MNSGC-Ballooning/MURI-HASP_2019/HASP_PCB/HASP_ThruHole/Schematic_rev1.brd

## EAGLE design SHADOMS_Flight_Computer/HASP_PCB/HASP_ThruHole/Schematic_rev1.brd (2019-06-05, last stored version)

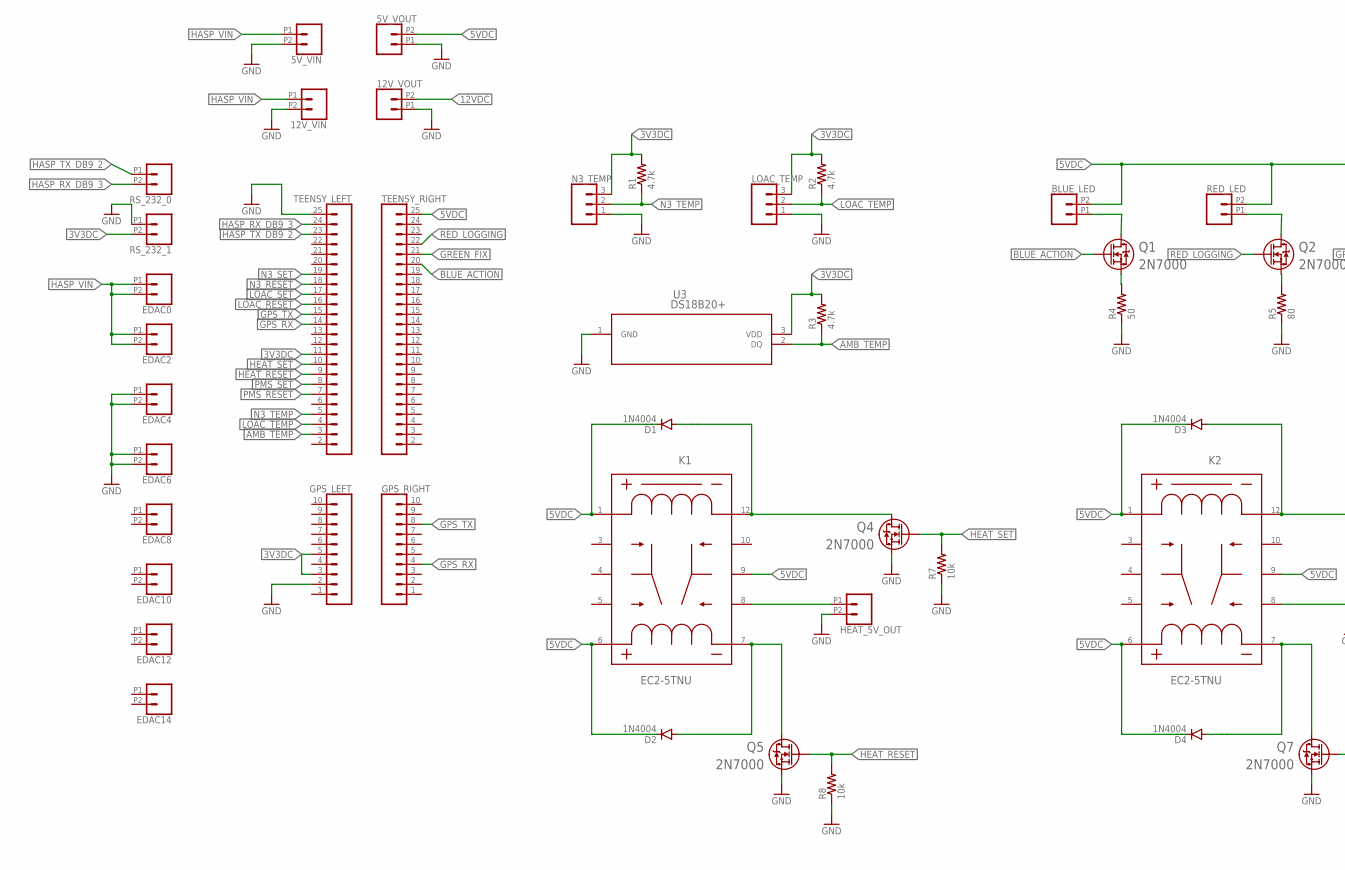
[picture p32: schematic Schematic_rev1.sch, part in row 1, column 1]

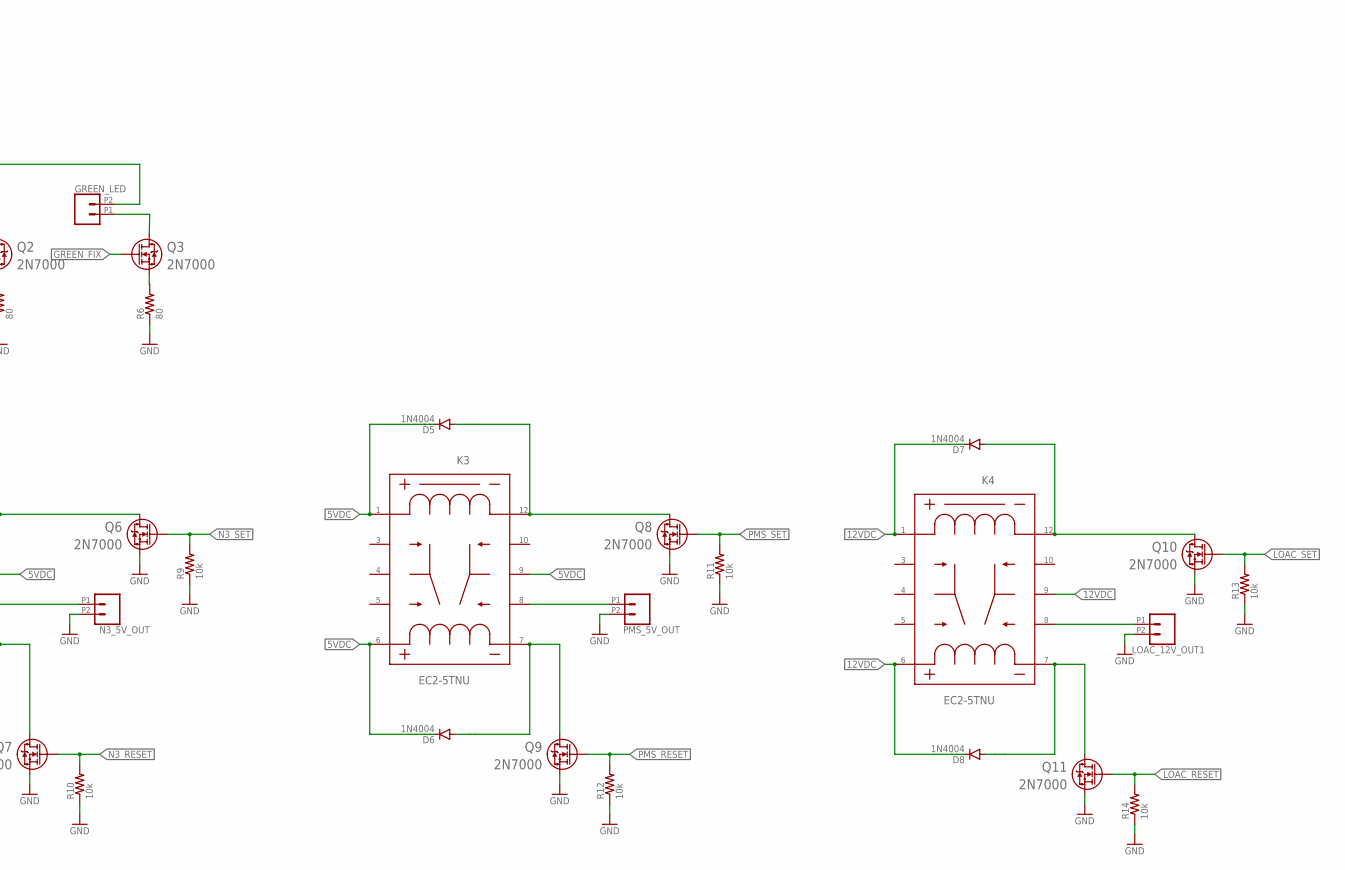
[picture p33: schematic Schematic_rev1.sch, part in row 1, column 2]

Parts:
5V_VIN, 5V_VOUT, 12V_VIN, 12V_VOUT: CONN_022.54MM_SCREWTERM; 1X02_2.54_SCREWTERM
BLUE_LED: CONN_022.54MM_SCREWTERM; 1X02_2.54_SCREWTERM
D1, D2, D3, D4, D5, D6, D7, D8: 1N4004; DO41-10
EDAC0, EDAC2, EDAC4, EDAC6, EDAC8, EDAC10, EDAC12, EDAC14: CONN_022.54MM_SCREWTERM; 1X02_2.54_SCREWTERM
GPS_LEFT: CONN_10"; 1X10
GPS_RIGHT: CONN_10"; 1X10
GREEN_LED: CONN_022.54MM_SCREWTERM; 1X02_2.54_SCREWTERM
HEAT_5V_OUT: CONN_022.54MM_SCREWTERM; 1X02_2.54_SCREWTERM
K1, K2, K3, K4: EC2-5TNU; EC2TNU
LOAC_12V_OUT1: CONN_022.54MM_SCREWTERM; 1X02_2.54_SCREWTERM
LOAC_TEMP: CONN_03; 1X03
N3_5V_OUT: CONN_022.54MM_SCREWTERM; 1X02_2.54_SCREWTERM
N3_TEMP: CONN_03; 1X03
PMS_5V_OUT: CONN_022.54MM_SCREWTERM; 1X02_2.54_SCREWTERM
Q1, Q2, Q3, Q4, Q5, Q6, Q7, Q8, Q9, Q10, Q11: 2N7000; TO-92
R1, R2, R3: 4.7k; 0207/7
R4: 50; 0207/7
R5, R6: 80; 0207/7
R7, R8, R9, R10, R11, R12, R13, R14: 10k; 0207/7
RED_LED: CONN_022.54MM_SCREWTERM; 1X02_2.54_SCREWTERM
RS_232_0, RS_232_1: CONN_022.54MM_SCREWTERM; 1X02_2.54_SCREWTERM
TEENSY_LEFT: CONN_24; 1X24
TEENSY_RIGHT: CONN_24; 1X24
U3: DS18B20+; 21-0248A

Connections:
3V3DC: GPS_LEFT.3, GPS_LEFT.5, LOAC_TEMP.3, N3_TEMP.3, R1.2, R2.2, R3.2, RS_232_1.P2 (2), TEENSY_LEFT.11, U3.3 (VDD)
5VDC: 5V_VOUT.P2 (2), BLUE_LED.P2 (2), D1.C, D2.C, D3.C, D4.C, D5.C, D6.C, GREEN_LED.P2 (2), K1.1, K1.6 (5), K1.9 (8), K2.1, K2.6 (5), K2.9 (8), K3.1, K3.6 (5), K3.9 (8), RED_LED.P2 (2), TEENSY_RIGHT.25
12VDC: 12V_VOUT.P2 (2), D7.C, D8.C, K4.1, K4.6 (5), K4.9 (8)
AMB_TEMP: R3.1, TEENSY_LEFT.3, U3.2 (DQ)
BLUE_ACTION: Q1.2 (1), TEENSY_RIGHT.20
GND: 5V_VIN.P2 (2), 5V_VOUT.P1 (1), 12V_VIN.P2 (2), 12V_VOUT.P1 (1), EDAC4.P1 (1), EDAC4.P2 (2), EDAC6.P1 (1), EDAC6.P2 (2), GPS_LEFT.2, HEAT_5V_OUT.P2 (2), LOAC_12V_OUT1.P2 (2), LOAC_TEMP.1, N3_5V_OUT.P2 (2), N3_TEMP.1, PMS_5V_OUT.P2 (2), Q4.1 (3), Q5.1 (3), Q6.1 (3), Q7.1 (3), Q8.1 (3), Q9.1 (3), Q10.1 (3), Q11.1 (3), R4.1, R5.1, R6.1, R7.1, R8.1, R9.1, R10.1, R11.1, R12.1, R13.1, R14.1, RS_232_1.P1 (1), TEENSY_LEFT.25, U3.1 (GND)
GPS_RX: GPS_RIGHT.4, TEENSY_LEFT.14
GPS_TX: GPS_RIGHT.8, TEENSY_LEFT.15
GREEN_FIX: Q3.2 (1), TEENSY_RIGHT.21
HASP_RX_DB9_3: RS_232_0.P2 (2), TEENSY_LEFT.24
HASP_TX_DB9_2: RS_232_0.P1 (1), TEENSY_LEFT.23
HASP_VIN: 5V_VIN.P1 (1), 12V_VIN.P1 (1), EDAC0.P1 (1), EDAC0.P2 (2), EDAC2.P1 (1), EDAC2.P2 (2)
HEAT_RESET: Q5.2 (1), R8.2, TEENSY_LEFT.9
HEAT_SET: Q4.2 (1), R7.2, TEENSY_LEFT.10
LOAC_RESET: Q11.2 (1), R14.2, TEENSY_LEFT.16
LOAC_SET: Q10.2 (1), R13.2, TEENSY_LEFT.17
LOAC_TEMP: LOAC_TEMP.2, R2.1, TEENSY_LEFT.4
N3_RESET: Q7.2 (1), R10.2, TEENSY_LEFT.18
N3_SET: Q6.2 (1), R9.2, TEENSY_LEFT.19
N3_TEMP: N3_TEMP.2, R1.1, TEENSY_LEFT.5
unnamed: BLUE_LED.P1 (1), Q1.3 (2)
unnamed: Q1.1 (3), R4.2
unnamed: D2.A, K1.7 (6), Q5.3 (2)
unnamed: Q2.3 (2), RED_LED.P1 (1)
unnamed: Q2.1 (3), R5.2
unnamed: Q3.1 (3), R6.2
unnamed: GREEN_LED.P1 (1), Q3.3 (2)
unnamed: D4.A, K2.7 (6), Q7.3 (2)
unnamed: D3.A, K2.12 (10), Q6.3 (2)
unnamed: D1.A, K1.12 (10), Q4.3 (2)
unnamed: K2.8 (7), N3_5V_OUT.P1 (1)
unnamed: D6.A, K3.7 (6), Q9.3 (2)
unnamed: HEAT_5V_OUT.P1 (1), K1.8 (7)
unnamed: D5.A, K3.12 (10), Q8.3 (2)
unnamed: K3.8 (7), PMS_5V_OUT.P1 (1)
unnamed: D8.A, K4.7 (6), Q11.3 (2)
unnamed: D7.A, K4.12 (10), Q10.3 (2)
unnamed: K4.8 (7), LOAC_12V_OUT1.P1 (1)
PMS_RESET: Q9.2 (1), R12.2, TEENSY_LEFT.7
PMS_SET: Q8.2 (1), R11.2, TEENSY_LEFT.8
RED_LOGGING: Q2.2 (1), TEENSY_RIGHT.22

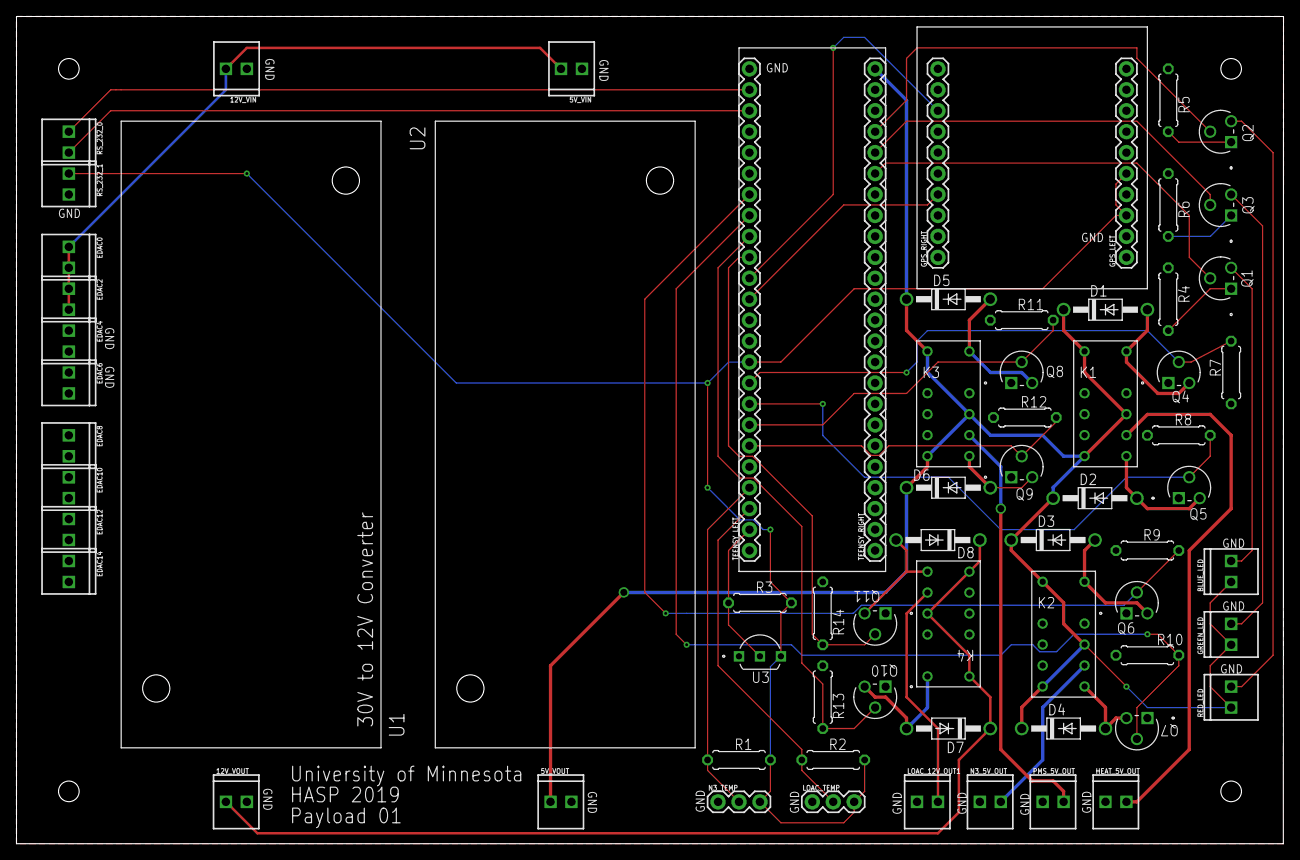
[picture p34: board Schematic_rev1.brd from above]

Board: 2 copper layers, 153.7 x 100.3 mm, 65 parts (0 on the bottom side), 41 nets.
