MNSGC-Ballooning/MURI-HASP_2019/SHADOMS_Flight_Computer/SHADOMS_Flight_Computer.ino

//SHADOMS Payload Flight Computer
//Version 1.0.1
//Payload 2019-01

/*This code operates the Teensy 3.5/3.6 Microcontroller on the 2019 HASP flight.
The goal of this flight is to collect data from the Plantower PMS-5003, the Alphasense N3,
and the LOAC-R. Then, this data will be compared to examine how each particle detector operates
in the conditions of the upper atmosphere. This examination will be utilized to determine OPC
effectiveness and calibration needs for future MURI research.

The code operates the particle counter power, writes the data of the Plantower to disk,
regulates temperature using active heating, runs a Coperinicus GPS, and controls uplink
and downlink with the main HASP gondola.

In this setup, both the Alphasense and the LOAC are running in a standalone mode where they 
record their own data.*/

//University of Minnesota- Twin Cities
//Candler-MURI Research Team
//Written in June 2019

//Version History
//Version 1.0.1
/*This version of the code has extra notes, in addition to comments, about things that might have been changed or done in a
different way if HASP was attempted again. Other documentation will be put up with the code in a folder for future reference.*/

//Version 1.0
/*This version of the code is modified to work with HASP serial connection. This code officially passed the HASP thermal
vaccuum, power, and operations tests. This is the code that will fly on the actual HASP flight.*/

//Version 0.4
/*This version seeks to counter the overheating problem by adding robust thermal control. The goal is to add active cooling,
and to turn off systems when they reach an unsafe operating temperature. This update also fixed the LOAC logging, which derives
its error from the transistor switch implemented for system shutdown. The flight timer was updated to successfully log the 
difference between flight start and poweron, and the SD Log was changed to add fillers when the data is not available.
The serial string now has the ability to send plantower data. Additionally, various bug fixes and code cleanup occurred.*/

//Version 0.3
/*Passed all individual unit tests and full system test. Updated update and log rates, updated GPS system. 
Returned system to hardware serial. Updated LED to show satellite count, and logging time. Added more debugging 
and code cleanup. Passed all initialization into functions separated by system. Added serial initialization pauses.*/

//Version 0.2
/*Passed initial unit tests for thermal control, GPS. This version also updates
the plantower logging system (returning to software serial), updates the LED pins, and fixes various bugs
and unclean code. The system log and the plantower log have also been collapsed.*/

//Version 0.1
/*Updated the serial port system to impliment hardware serial connections in place of software serial.
This will allow for the system to interface with multiple serial systems simaltaneously. This version also
implemented the serial interface with the HASP gondala and established meanings for the LEDs.*/

//Version 0.0
/*This is the initial code after the first stage of debugging.*/



/////SYSTEM DEFINITIONS\\\\\



//Libraries
  #include <SD.h>                                       //Writing to SD card
  #include <OneWire.h>                                  //Dallas data control
  #include <DallasTemperature.h>                        //Dallas temperature control
  #include <TinyGPS++.h>                                //GPS control
  #include <LatchRelay.h>                               //Relay control

//Pin Definitions
  #define sdLED 23                                      //LED pin which blinks to indicates data logging to the SD            NOTE: An OLED screen can be used to replace LEDs
  #define fixLED 22                                     //LED pin which blinks to indicate GPS fix
  #define stateLED 21                                   //LED pin which blinks to indicate an active data recording status
  #define wireBus1 29                                   //Temperature sensor 1 pin - Internal Ambient
  #define wireBus2 30                                   //Temperature sensor 2 pin - External Ambient
  #define wireBus3 31                                   //Temperature sensor 3 pin - OPCs
  #define heater_ON 24                                  //Heater relay pins
  #define heater_OFF 25                                 //^^^
  #define alphaOPC_ON 5                                 //Alphasense OPC relay pins
  #define alphaOPC_OFF 6                                //^^^
  #define planOPC_ON 26                                 //Plantower OPC relay pins
  #define planOPC_OFF 27                                //^^^
  #define LOAC_ON 7                                     //LOAC OPC power relay pins
  #define LOAC_OFF 8                                    //^^^
  #define LS_PD 35                                      //LOAC state shutdown transistor
  #define LOAC_FAN 32                                   //LOAC fan pin
  
//Serial Pins
/*  
  #define HASP_RX 0                                     //HASP Recieve Pin                SERIAL 1
  #define HASP_TX 1                                     //HASP Transmission Pin
  #define GPS_RX 9                                      //GPS Recieve Pin                 SERIAL 2
  #define GPS_TX 10                                     //GPS Transmission Pin
  #define PMS_RX 34                                     //PMS Recieve Pin                 SERIAL 5
  #define PMS_TX 33                                     //PMS Transmission Pin (Unused) 
*/
 
//Constant Definitions
  #define LOG_RATE 7000                                 //These definitions are the rates of the individual portions of the
  #define UPDATE_RATE 1                                 //systemUpdate function.
  #define FIXLED_LOOP 15000                             //FixLED cycles every 15 seconds
  #define FIXLED_RATE 500                               //FixLED is held on for 0.5 seconds
  #define NOFIXLED_RATE 3000                            //When there is no GPS fix, FixLED cycles is held on for 3 seconds
  #define DWN_BYTES 57                                  //Number of downlink bytes + 1 (the +1 makes it work)
  #define COLD 280.0                                    //Minimum acceptable temperature of the OPC
  #define HOT 290.0                                     //Maximum acceptable temperature of the OPC
  #define KELVIN 273.15                                 //Number to convert Celcius to Kelvin
  #define INFLIGHT_START_ALT 10000                      //Altitude in feet where the inFlight condition is set to true
  #define MIN_FANTEMP 300.0                             //Minimum acceptable temperature of the OPC for active cooling
  #define MAX_TEMP 313.1                                //Maximum operating temperature of the OPC
  #define MIN_TEMP 243.2                                //Minimum operating temperature of the OPC
  #define OVERRIDE_TIME 1500000                         //Time of the override command
  
//Relay Definitions
  LatchRelay heater(heater_ON, heater_OFF);             //Define heater relay object
  LatchRelay alphaOPC(alphaOPC_ON, alphaOPC_OFF);       //Define Alphasense OPC relay object
  LatchRelay planOPC(planOPC_ON, planOPC_OFF);          //Define Plantower OPC relay object
  LatchRelay LOAC(LOAC_ON, LOAC_OFF);                   //Define LOAC OPC power relay object
  bool dataCollection = false;
  
//Thermal Control Definitions
  bool coldOPC = false;
  bool hotOPC = false;
  bool danger = false;                                  //danger runs an emergency shutdown of the OPC system
  bool overRide = false;                                //manual system override mechanism
  unsigned long overrideTimer = 0;
  char fanState = '0';                                  //Defines the stae of the LOAC fan. "0" means off, "1" means on
  bool initialCheck = false;

//Temperature Sensor Definitions
  OneWire oneWire1(wireBus1);                           //Temperature sensor 1 data interface
  OneWire oneWire2(wireBus2);                           //Temperature sensor 2 data interface
  OneWire oneWire3(wireBus3);                           //Temperature sensor 3 data interface
  DallasTemperature temperature1(&oneWire1);            //Temperature sensor 1
  DallasTemperature temperature2(&oneWire2);            //Temperature sensor 2
  DallasTemperature temperature3(&oneWire3);            //Temperature sensor 3
  float t1;                                             //Temperature 1
  float t2;                                             //Temperature 2
  float t3;                                             //Temperature 3
  char heatState = '0';                                 //heat pad status (1 = on)
  
//Serial Definitions (HASP Communication)
  String flightState = "";
  String OPCState = "";
  String dataPacket = "";
  byte packet[DWN_BYTES] = {0};                         //50 char/bytes in the string (54 with checkbytes)                    NOTE: The checkbytes act as start and stop bytes. 
  
//Data Log Definitions
  const int chipSelect = BUILTIN_SDCARD;                //Access on board micro-SD
  File fLog;                                            //This part of the code establishes the file and
  String data;                                          //sets up the CSV format
  String Fname = "";                                    //This is the name of the CSV file
  String header = "";                                   //This is the head of the CSV file
  bool sdLogging = false;                               //This variable is used to indicate when logging occurs
  
//Plantower Definitions
  String dataLog = "";                                  //Used for data logging                                               NOTE: A library now exists for OPCs.
  int nhits=1;                                          //Used to count successful data transmissions    
  int ntot=1;                                           //Used to count total attempted transmissions
  bool goodLog = false;                                 //Used to check if data is actually being logged
  int badLog = 0;                                       //Counts the number of failed log attempts
  //String filename = "ptLog.csv";                      //File name that data wil be written to
  //File ptLog;                                         //File that data is written to 
                  
  struct pms5003data {
    uint16_t framelen;
    uint16_t pm10_standard, pm25_standard, pm100_standard;
    uint16_t pm10_env, pm25_env, pm100_env;
    uint16_t particles_03um, particles_05um, particles_10um;
    uint16_t particles_25um, particles_50um, particles_100um;
    uint16_t unused;
    uint16_t checksum;
  } planData;                                           //This struct will organize the plantower bins into usable data
  
  //GPS Definitions
  TinyGPSPlus GPS;                                      //GPS object definition
  
  //FlightChecker() variables
  bool inFlight = false;                                //Bool that determines if the payload is in flight. Used with FlightCheck function
  unsigned long flightStart = 0;                        //Time passed since inFlight became true
  byte FlightCheckCounter = 0;                          //If this reaches 5, then inFLight should be set to true

  //Variables for UpdateGPS()
  unsigned long lastGPS = 0;                            //Time in seconds since the last GPS update
  unsigned long GPSstartTime = 0;                       //When the GPS starts, time in seconds of last GPS update
  uint8_t days = 0;                                     //If we're flying overnight this serves as a coutner for time keeping

  //timers and other variables for fixLED
  unsigned long fixLED_loop_timer = 0;                  //timer to ensure that the fixLED will do "something" every 10 second loop
  bool fixLEDon = false;                                //indicates if the fixLED is on or not
  bool fixLEDshort = false;                             //indicates what LED flash sequence to follow
  
  //strings that populate GPS data strings
  String GPSdata = "";                                  //Initializes data string that prints GPS data to the SD card
  String flightstring = "False";                        //Indicates if inFlight is active or not
  String faillatitude = "0.00";                         //Printed latitude if GPS does not have a fix or any data
  String faillongitude = "0.000000";                    //Printed longitude if GPS does not have a fix or any data
  String failalt = "0.000000";                          //Printed altitude if GPS does not have a fix or any 

  //LED Definitions
  bool fixLight = false;                                //These booleans are for the light activation and deactivation logic  
  bool stateLight = false;

  //Updater Definitions                                 //These values help to regulate the speed of the updater function
  unsigned long lastCycle = 0;
  unsigned long planCycle = 0;
  


/////ACTIVE CODE\\\\\                              



void setup() {                                       
  systemInit();                                         //This will initalize the system
  digitalWrite(fixLED, HIGH);                           //This will blink the LEDs to indicate startup.
  digitalWrite(sdLED, HIGH);
  digitalWrite(stateLED, HIGH); 
  delay (1000);
  digitalWrite(fixLED, LOW);
  digitalWrite(sdLED, LOW);
  digitalWrite(stateLED, LOW); 
  delay(1000);
  digitalWrite(fixLED, HIGH);
  digitalWrite(sdLED, HIGH);
  digitalWrite(stateLED, HIGH); 
  delay (1000);
  digitalWrite(fixLED, LOW);
  digitalWrite(sdLED, LOW);
  digitalWrite(stateLED, LOW); 
}

void loop() {
  systemUpdate();                                       //This function will update the full system  
}
