MNSGC-Ballooning/MURI-HASP_2019/(commit log)

2019-06-03 Added flight timer
2019-06-03 Commented the flight timer.
2019-06-03 Added sensor update function.
2019-06-05 HASP PCB Files
    [Schematic_rev1.brd, Schematic_rev1.sch]
2019-06-11 Replaced software serial ports with hardware serial ports.
    [Plantower.ino, SHADOMS_Flight_Computer.ino]
2019-06-14 edited LED functions
2019-06-17 added serial to flight timer
2019-06-18 Removed stupid TinyGPS Glitch (Hopefully)
    [SHADOMS_Flight_Computer.ino]
2019-06-18 removed old serial test and replaced with up to date one
    [Serial_Test.ino]
2019-06-19 Replaced LOAC shutdown relay logic with transistor gate logic.
    [SHADOMS_Flight_Computer.ino, Serial_Uplink_Downlink.ino, Updater.ino]
2019-06-21 added Sensor Unit test
2019-06-24 made changes to ground code for Serial Test and added code to run on payload for Serial Test
2019-06-24 Finished Sensor test, updated flight computer to V1.2
2019-06-26 LED update
2019-06-26 Fully integrated GPS capabilities and fixLED sequences.
    [SD_Write.ino, SHADOMS_Flight_Computer.ino, Updater.ino]
2019-06-26 Added unique FixLED cycle to Copernicus GPS unit test.
    [CopernicusGPSTest.ino, FixLEDUpdater.ino]
2019-06-28 Simlified the fixLED sequence.
    [1-System.ino, 4-GPS.ino, flightComputerTest.ino]
2019-06-28 Fixed flight timer
2019-06-28 Updated main code, tested GPS fix
    [1-System.ino, 4-GPS.ino, SHADOMS_Flight_Computer.ino]
2019-07-02 made it so serial downlink also sends down a sample of bin 2 on the plantower
2019-07-02 added a test string to serial for thermal test
    [Schematic_rev1.brd, Schematic_rev1.sch]
2019-07-03 Altered the Serial downlink string to include data from bin #2 on the PMS
    [Schematic_rev1.brd, Schematic_rev1.sch]
2019-07-03 bug fixes, thermal vac
    [1-System.ino, 2-Flight_Timer.ino, 3-Thermal_Control.ino, 5-OPC.ino, 6-SD.ino, 7-Serial.ino, SHADOMS_Flight_Computer.ino, flightComputerTest.ino]
2019-07-08 Updated thermal control to give LOAC fan functionality.
2019-07-09 Added transistor switch unit test
2019-07-22 updated HASP PCB location
    [Schematic_rev1.brd, Schematic_rev1.sch]
